anake-an/asthma-monitoring-system/hardware/README.md

# RespiroSync Hardware Integration

This directory contains the firmware source code for the physical IoT hardware used in the RespiroSync Asthma Monitoring System. The architecture utilizes a **Dual-Processor Design** to handle complex Acoustic AI alongside standard environmental telemetry.

## 1. ESP32 Master Gateway (`esp32_firmware/esp32_firmware.ino`)
The ESP32 is the central brain of the hardware system. 
*   **Connectivity:** Uses `WiFiManager` to broadcast a "RespiroSync-Setup" Hotspot if it can't find WiFi. Securely connects to Cloudflare WebSockets (WSS).
*   **Environment:** Polls the DHT22 (Climate), Sharp GP2Y1010AU0F (Dust/PM2.5), and MQ-135 (Gas, estimated ppm) sensors every 3 seconds.
*   **Comms:** Listens to UART2 (Serial2) for acoustic triggers from the Raspberry Pi Pico.
*   **Broker:** connects as the `respirosync_device` account with client id = its pairing token, and only uses `respirosync/devices/<token>/...` topics.
*   **Local alarm:** applies the thresholds it receives from the dashboard (retained `config` topic) and beeps/turns the red LED on when a reading crosses one, even when offline.
*   **LCD (16×2):** every line is centred, and only changed characters are rewritten, so it never flickers.
    *   **Start-up:**
        1. "RespiroSync ♥" slides in.
        2. "Connecting WiFi" (or "WiFi setup / Join RespiroSync" when the setup hotspot opens).
        3. "WiFi connected" with the network name.
        4. "Setting clock".
        5. "Connecting cloud".
        6. "Ready ♥ / Monitoring room".
    *   **Pages, every 5 s:** the title stays on the top line, the values sit side by side on the bottom line.
        1. **Air quality:** PM2.5 (µg/m³, shown as `ug`) and gas (ppm), e.g. `12.4ug  420ppm`. For the first **3 minutes** after power-on the gas sensor warms up: it is not read, the LCD shows a countdown (`Gas 2:15`), and gas is sent to the server as empty.
        2. **Room climate:** temperature and humidity, e.g. `28.5C  64%`, or "Check sensor" when the DHT22 fails.
        3. **Clock:** time with the online/offline icon, and the date (Malaysia time).
        4. **Daily dose? (only while due):** shown while the child's daily dose is overdue. The server sends `dose_due` in the config: a daily inhaler is used, but none was logged for 26 h.
    *   **Over a limit:** the backlight blinks 3 times and the screen stays on e.g. `!! DUST HIGH !!` / `38 > limit 35` until the reading is back under the limit. Several readings over their limits take turns every 2 s.
    *   **Other screens:**
        *   **Cough:** "Cough heard" with a moving pulse, for 2 s.
        *   **Alert from the app:** "!! ALERT !!".
        *   **Connection drops:** "Offline / Alarms still on".
    *   **Clock source:** the internet time servers (NTP). Where a network blocks those (UDP port 123), the device asks the server over MQTT (a `time_request` event, answered with a `set_time` command), every 30 s until it has the time.
    *   **Night mode (21:00-07:00, can be switched off per room in Smart Alerts):** the backlight is off unless there is an alarm or a cough. It also lights up for 30 s after the board's **BOOT** button is pressed. Outside night mode, the BOOT button shows the next page.

## 2. Raspberry Pi Pico (Acoustic AI Coprocessor)
The Raspberry Pi Pico (the **Edge AI** module) listens for coughs, so the ESP32 never handles audio.
*   **Cough model:** `pico_cough_ai/pico_cough_ai.ino` runs an Edge Impulse neural network (Audio MFE + 1D CNN, int8) from `libraries/RespiroSync_Cough_inferencing`. Core 1 records the INMP441 without a break; core 0 classifies the last second every 0.5 s (about 260 ms of work) and reports `COUGH:<level>,<score>` when the cough score, averaged over two windows in a row, reaches 0.6. Level 1-4 is the loudness, the score is how sure the model is.
*   **Training data, settings and results:** [`docs/EDGE_IMPULSE.md`](../docs/EDGE_IMPULSE.md) (93 % on validation, 86 % on unseen test sounds).
*   **Core:** use the **arduino-pico** core by Earle Philhower ("Raspberry Pi Pico/RP2040" in Boards Manager). The sketches use its `I2S i2s(INPUT)` API.
*   **Library (USB flashing only):** copy `libraries/RespiroSync_Cough_inferencing` into `Documents/Arduino/libraries`. GitHub Actions uses it straight from the repo.
*   **Checking it:** set `DEBUG_SCORES 1` and open the Serial Monitor (115200) to see every cough score.

---

## Training the model on this microphone

The model was trained on public recordings (see `docs/EDGE_IMPULSE.md`). Recordings made with the device's own INMP441 make it fit the real rooms:

1. **Flash the data collector:** `pico_cough_ai/data_collection/data_collection.ino` streams 16 kHz audio over USB, converted exactly like the Edge AI firmware does it.
2. **Stream to Edge Impulse:** install the CLI (`npm install -g edge-impulse-cli`) and run `edge-impulse-data-forwarder --frequency 16000`; it links the Pico to the "RespiroSync Cough" project.
3. **Record:** coughs labelled `cough`, and 5-10 minutes of the home labelled `noise` (talking in Malay and English, TV, fan, children playing, quiet).
4. **Retrain and test** in the Studio, then export the **Arduino library** and ship it as an Edge AI update (steps in `docs/EDGE_IMPULSE.md`).

---

## Setup Instructions

1.  Open `WIRING_GUIDE.md` and wire all hardware exactly as specified.
2.  Copy `esp32_firmware/secrets.example.h` to `esp32_firmware/secrets.h` and fill in the broker URL and the device password.
    Delete `esp32_firmware.example.ino` if it is still in the folder: the IDE compiles every `.ino` in a sketch folder together.
3.  Open `esp32_firmware/esp32_firmware.ino` in the Arduino IDE. It needs these libraries: WiFiManager, ArduinoJson 6 or 7, DHT sensor library, LiquidCrystal_I2C.
4.  Under **Tools**, choose:
    *   **Board:** "ESP32 Dev Module".
    *   **Partition Scheme:** "**Minimal SPIFFS (1.9MB APP with OTA/190KB SPIFFS)**". It has the two app slots that cloud updates need; the default scheme is too small.
5.  Connect your ESP32 via USB and click **Upload**.
6.  Once it has started, use your phone to connect to the **RespiroSync-Setup** Wi-Fi network, then enter your Wi-Fi password and the token from the dashboard.
7.  Open `pico_cough_ai/pico_cough_ai.ino` in the Arduino IDE with the arduino-pico core selected.
8.  Connect your Raspberry Pi Pico via USB and click **Upload**. The first time, hold **BOOTSEL** while plugging it in (it appears as the RPI-RP2 drive).
9.  Mount the hardware in the bedroom and monitor the dashboard!

## Updating the ESP32 from the cloud (OTA)

Once a device runs firmware 3.0.0 or newer (flashed once over USB with the partition scheme above), new versions are installed over the internet. Nothing needs to be on the same Wi-Fi. Versions read like `3.1.0 Build 261011`; see `FIRMWARE_HISTORY.md`.

**Automatic (recommended):**
1.  Raise `FIRMWARE_VERSION` (e.g. `"3.1.1"`), write what owners should read in `WHATS_NEW.txt` (one plain point per line), and push to `main`.
2.  GitHub Actions builds the firmware with the real broker settings and uploads it to the server (job "Publish ESP32 firmware to the server").
3.  Owners see the update in the dashboard.

The `.bin` contains the device password, so it is never stored in GitHub (no artifact, no release).

One-time setup:
*   **NAS:** in `backend/.env`, add `FIRMWARE_UPLOAD_TOKEN=` followed by a long random value (`openssl rand -hex 32`), then `docker compose up -d --force-recreate backend`.
*   **GitHub:** repository → Settings → Secrets and variables → Actions → New repository secret. Add these five:

| Secret | Value |
|---|---|
| `MQTT_URI` | the same as in your `secrets.h` |
| `MQTT_USERNAME` | the same as in your `secrets.h` |
| `MQTT_PASSWORD` | the same as in your `secrets.h` (no `"` or `\` in it) |
| `FIRMWARE_UPLOAD_URL` | `https://app.respirosync.online/api/firmware/upload` |
| `FIRMWARE_UPLOAD_TOKEN` | the same value as on the NAS |

If Cloudflare's "Bot Fight Mode" is on, it may block the upload; turn it off, or skip the challenge for `/api/firmware/upload`.

**By hand (without GitHub):**

**1. Build** (developer, on the PC):
1.  In `esp32_firmware.ino`, raise `FIRMWARE_VERSION` (e.g. `"3.1.1"`).
2.  In the Arduino IDE, keep the same board and partition scheme. Then **Sketch → Export Compiled Binary**.
3.  The file you need is `build/.../esp32_firmware.ino.bin`, not `.merged.bin` or `.bootloader.bin`.

**2. Publish** (developer, on the NAS):
1.  Copy the `.ino.bin` into `backend/storage/app/firmware/` in the project folder (e.g. with the NAS file manager).
2.  Run:
    ```bash
    sudo docker compose exec backend php artisan firmware:publish storage/app/firmware/esp32_firmware.ino.bin --notes="What changed"
    ```
    It checks the file is an ESP32 app image that fits, reads the version from it, and keeps it as `esp32-<version>.bin`.
3.  `--list` shows the published versions, and `--remove=3.1.1` withdraws one.

**3. Install** (owner, in the dashboard):
1.  Owners see a banner ("An update is available for Ali Bedroom") and a dot on **Account Settings**. Under **Rooms**, the device shows "Firmware 3.1.0 · ● Update available" and an **Update** button. The dialog lists "What's new" and has **Later** / **Update now**.
2.  The device must be online, and no alarm may be active.
3.  The LCD shows **Updating 45%** / **Don't unplug**, then "Update done", and restarts. Rooms then shows **✓ Up to date**.

**Safety:**
*   **The link:** the device downloads over HTTPS through a one-time link (valid 10 minutes, only for that device).
*   **The checksum:** after writing the image, the device compares its SHA-256 with the published one. On a mismatch it keeps the old firmware.
*   **Rollback:** the new firmware must reach the cloud within 2 minutes, or the ESP32 starts the previous firmware again. Rooms then shows "Update failed" with the reason. A failed download also leaves the old firmware running.
*   **Not done here:** the image is not cryptographically signed. Commercial devices also use secure boot / signed images. That burns keys into the chip permanently, so it is left out of this prototype.

## Updating the Edge AI module (Pico) from the cloud

The Pico has no internet of its own: the ESP32 downloads its update from the server, checks it (SHA-256), and sends it over the UART link. The Pico stores it in its file-system area and installs it on restart. It needs **ESP32 firmware 3.3.0+** and **Edge AI 2.0.0+**.

**One-time setup** (in this order):
1.  Update the ESP32 to **3.3.0** from the dashboard. It now talks to the Pico at 115200 baud, so coughs pause until step 2.
2.  Flash the Pico once over USB:
    *   pull the VSYS wire off first, if the Pico is powered from the ESP32;
    *   select Board "Raspberry Pi Pico" and **Tools → Flash Size → "2MB (Sketch: 1MB, FS: 1MB)"**;
    *   upload `pico_cough_ai/pico_cough_ai.ino`, then put the VSYS wire back.
3.  Within 30 seconds, Rooms in the dashboard shows **Edge AI 2.0.0**.

**After that:** raise `EDGE_AI_VERSION`, write `pico_cough_ai/WHATS_NEW.txt`, and push to `main`. GitHub Actions builds the Edge AI firmware and uploads it. Owners see **Edge AI · ● Update available** under Rooms and press **Update**; the LCD shows `Updating 45%` / `Edge AI`. A new Edge Impulse model ships the same way, inside the Pico firmware.

By hand: export the Pico build (Sketch → Export Compiled Binary, with the same Flash Size), copy `pico_cough_ai.ino.bin` (not the `.uf2`) into `backend/storage/app/firmware/`, and run `php artisan firmware:publish storage/app/firmware/pico_cough_ai.ino.bin`.
