anake-an/asthma-monitoring-system/docs/PROJECT_EXPLANATION.md

# 🫁 RespiroSync: System Architecture & Code Explanation

How the hardware, AI, backend and frontend fit together, what each part really does, and where the code lives.

---

## 1. Hardware (dual-processor)

### 🎤 Raspberry Pi Pico: Edge AI cough detector
*   **Hardware:** Raspberry Pi Pico + INMP441 I2S microphone.
*   **Why a second chip:** continuous 16 kHz audio sampling is kept off the ESP32, which handles Wi-Fi, TLS and sensors.
*   **How it works:** an Edge Impulse neural network (Audio MFE features + a small 1D CNN, int8) classifies each second of sound as **cough** or **noise**. Core 1 records without a break; core 0 classifies the last second every 0.25 s (about 140 ms on the RP2040). A cough is reported when 2 of the last 3 windows reach the room's threshold (0.6 to start, tuned by the cough reviews), at most once per 1.5 s; a window with a clear burst is first scaled into the loudness band the model learned (level guard). A watchdog restarts the Pico if it hangs.
*   **Accuracy:** 93 % on validation and 86 % on test sounds it never heard (84 % of coughs caught, 87 % of other sounds ignored, the rest marked uncertain and not reported). Training data and settings: `docs/EDGE_IMPULSE.md`.
*   **Limits (be honest in the report):** trained on public recordings (phones, a lab microphone), not yet on the INMP441 in a real home, so it can miss coughs or take another sound for one. Recording the home through the device and retraining (`hardware/README.md`) is the next step. It recognises a cough sound; it does not diagnose anything.
*   **Code:** `hardware/pico_cough_ai/pico_cough_ai.ino`, model in `hardware/libraries/RespiroSync_Cough_inferencing`
*   **Output:** `COUGH:<level 1-4 (loudness)>,<cough score 0.00-1.00>` over UART to the ESP32.

### 📡 ESP32: gateway and environment monitor
*   **Hardware:** ESP32 + DHT22 + MQ-135 + Sharp GP2Y1010AU0F (or the pin-compatible GP2Y1014AU0F), passive buzzer, red/green LEDs, 16x2 I2C LCD behind a BSS138 level shifter, MB-102 5 V supply for the sensors.
*   **How it works:**
    *   Reads the sensors every 3 s and publishes them to `respirosync/devices/<token>/telemetry`. Dust and gas are averaged over the last 4 readings (~12 s); the same smoothed values drive the local alarm, so the device and dashboard agree. A failed DHT22 read is sent as `null`, never as 0. Gas is an estimated CO₂-equivalent ppm (MQ-135 datasheet curve, calibrated against the cleanest air seen since power-on taken as 420 ppm), not a measured CO₂ value.
    *   Forwards each Pico detection to `respirosync/devices/<token>/events`.
    *   Receives its owner's thresholds on `respirosync/devices/<token>/config` (a retained message, so they arrive again after every reconnect) and sounds the buzzer/red LED when a reading stays over its threshold for 3 readings in a row (about 9 s on top of the 12 s average); it stops after 3 readings under the threshold minus a margin, so a value hovering at its limit does not switch it on and off. This works offline too, using the last thresholds received (kept in flash across restarts, firmware 3.5.0). The dashboard can mute the buzzer; holding the board's BOOT button for 2 s silences it for 10 minutes. Coughs heard while offline are kept (up to 40, with their time) and sent when the connection is back; the server stores them without an alert.
    *   Obeys `factory_reset`, `buzzer_on`, `buzzer_off` and `set_time` on `respirosync/devices/<token>/commands`.
    *   **LCD:** every line is centred.
        *   Start-up steps, then pages every 5 s: Air quality, Room climate, the clock, and "Daily dose?" while one is due.
        *   Alerts and coughs interrupt the pages; night mode switches the backlight off from 21:00 to 07:00.
        *   The gas sensor is not read for its first 3 minutes (warm-up).
        *   The clock comes from NTP, or from the server over MQTT where NTP is blocked.
        *   Cloud firmware updates: owners press Update in the dashboard; the device downloads the new build from the server over HTTPS, checks its SHA-256, installs it and rolls back if it does not reach the cloud.
*   **Code:** `hardware/esp32_firmware/esp32_firmware.ino` (credentials in a gitignored `secrets.h`).

---

## 2. AI

### A. On-device detection
The Edge Impulse cough model on the Pico, above. It produces cough events with a score; it does not diagnose anything.

### B. Cloud risk model (`ai_engine/main.py`, FastAPI + scikit-learn)
*   **Two levels (DESIGN §5):** a **room model per device** (`/train/room?device_id=`, `device_<id>_baseline.pkl`: what is normal for that room, needs only telemetry) and a **risk model per child** (`/train/risk?patient_id=`, `patient_<id>_model.pkl`: what preceded that child's rescue doses and cough clusters, from the windows of all of their rooms in time order; shared rooms never train a child's model). `/predict?device_id=` answers for one room: its baseline (Stage 1) or its child's risk model fed with that room's latest window (Stage 2), with limits from the room's own learned normal. The backend checks access before every call (`AiController`, `ai:optimize`); `php artisan ai:train` (every 4 h) trains every room, then every child.
*   **Data:** 10-minute windows of average PM2.5, temperature and humidity, cough count, and whether a controller (daily) dose was logged in the last 24 h. Gaps up to 30 minutes are interpolated; longer gaps (device offline) are dropped rather than invented. Cough events the caregiver marked as **false alarm** are excluded.
*   **Label:** "a rescue inhaler dose or 2+ coughs within the next 60 minutes". Controller (daily, preventive) doses are not episodes; they are the input above.
*   **Stage 1 (no events yet):** z-score of the current readings against the room's own baseline → one of three fixed levels (shown as Normal / Unusual / Very unusual). An anomaly level, not a probability.
*   **Stage 2 (enough episodes):** below 12 episode windows (about 2 episodes) the account stays on Stage 1. Then logistic regression (stable on little data), and a Random Forest from 20 episode windows (about 4 episodes); both with balanced class weights. Evaluation on the most recent 25% of windows, which the model did not train on, reports **recall** (share of later episodes it flagged) and **precision** (share of its warnings that were real), never plain accuracy (about 95% of windows are "safe", so always saying "safe" would score about 95%). With fewer than 2 later episode windows, no score is claimed.
*   **Threshold suggestions:** `/predict` returns suggested thresholds learned from the room: mean + 3 std of each room reading (gas keeps 1000 ppm: the MQ-135 estimate drifts too much to learn), tightened toward mean + 2 std as Stage 1 sees the room as unusual / very unusual, or by the Stage 2 risk model; never below the room's own normal range (mean + 2 std) and always within a safety range. The scheduler runs `php artisan ai:optimize` every 5 minutes for every account with "AI optimization" enabled. Each limit the user sets in Smart Alerts is a **cap**: the AI may lower the effective limit below it (toward the learned limit, further when the room is unusual), never raise it above, and never changes a **locked** limit. It changes nothing until the room baseline covers 24 h of readings, and then changes each limit at most once per 24 h, by at most 10 % (a user change starts a fresh day for that limit; lowering the cap always applies at once). While the AI is learning or has less than 24 h of readings, every limit is the user's own value. Every change is logged with its reason and shown in the Activity Log, one line per update. Devices are only re-published when a limit changes. The dashboard marks limits the AI lowered ("AI"), locked limits ("locked"), and limits inside the room's usual range ("!", expect frequent alerts).
*   **Missed daily dose rule (a rule, not AI):** if the account logged a daily (controller) dose in the last 7 days but none in the last 26 h, `ai:optimize` lowers every unlocked limit by 15 % until a dose is logged (`hardware_configs.missed_dose_base` keeps the limits without the rule, so it never compounds). Accounts that never log daily doses are never affected. Changes are logged as "Rule"; the dashboard marks the limits "dose". Turning AI optimization off restores every limit to the user's own value and ends the rule.

---

## 3. Backend & cloud infrastructure

### 📨 Mosquitto (MQTT broker): `mosquitto/config/`
*   `allow_anonymous false`, with two accounts: `respirosync_backend` (full access to `respirosync/#`) and `respirosync_device` (shared by devices).
*   `acl` pins every device to `respirosync/devices/<its client id>/...`. A device cannot read another device's data, learn other tokens, or publish as another device. The password file is created on the server and never committed.

### ⚙️ Laravel 12
*   **MQTT worker:** `app/Console/Commands/MqttSubscribe.php` subscribes to `respirosync/devices/+/telemetry` and `/events` and hands each message to `app/Services/DeviceMessageHandler.php`. Device identity comes from the topic, never from the payload.
*   **Alert rule:** a cough raises an alert when there are **3 coughs in 10 minutes**, or **2 coughs in 10 minutes where this one has a cough score ≥ 0.8**. A single cough never alerts on its own. At most **one email per device per 10 minutes**. A mail failure is logged and never stops the worker.
*   **Other alerts (email + push, same recipients):**
    *   **A reading over its room's limit for 5 minutes**, at most once an hour per reading (`DeviceMessageHandler::checkLimits`).
    *   **A device silent for 30 minutes**, once per outage, with a "back online" push afterwards (`devices:offline-alerts`).
    *   **On the LCD only:** "Daily dose?" while a child's daily dose is overdue (`devices:dose-reminders`).
*   **Alert email:** `resources/views/emails/cough_alert.blade.php` shows the cough count and the device-reported cough score, or "Not reported by device". It never shows an invented confidence.
*   **Patients, rooms and access:** a **patient** (the child: display name, optional birth year) is separate from the login; `patient_user` gives each account a role (owner now; caregiver and viewer with sharing). A **device** is a room: it belongs to one child or is a **shared room** (coughs shown, never counted for a child). Alert limits (`hardware_configs`) are **per device**; inhaler doses (`inhaler_logs.patient_id`) are per child; telemetry and coughs come from the device. Every API call resolves its `device_id` / `patient_id` through one check (`AppPoliciesDevicePolicy`, `PatientPolicy`, `Controller::device()` / `::patient()`): anything not yours is a 404. Devices record `last_seen_at` on every message; online = a message in the last 20 s.
*   **REST API:** `routes/api.php`, protected by Sanctum tokens.
*   **Tests:** `backend/tests/` (`php artisan test` on a development machine or an isolated container; never inside the production backend container, see README).

---

## 4. Frontend (`frontend/`)
*   **Live Monitor:** latest readings; shows "Sensor Error" when the DHT22 failed.
*   **Command Center:** thresholds and buzzer mute. Saving pushes the new config to every device on the account.
*   **AI Risk panel:** model stage, risk level, and coughs in the last hour.
*   **Cough History:** each event's cough score and whether it was an Alert or only Logged; caregivers can mark events as false alarms, which then feeds into training.

---

## 5. Deployment & security
*   **Docker Compose:** frontend, backend, MQTT worker, scheduler, AI engine, MySQL, Mosquitto, cloudflared. Secrets come from `.env` (see `.env.example`).
*   **Cloudflare Tunnel:** the NAS opens an outbound tunnel. The dashboard and the broker's WebSocket listener are reachable through Cloudflare without port forwarding, and every service binds only to `127.0.0.1` on the host.
*   **Broker hardening:** authentication + per-device ACL (above). TLS terminates at Cloudflare, and the ESP32 verifies Cloudflare's certificate.
