anake-an/asthma-monitoring-system/hardware/WIRING_GUIDE.md

# RespiroSync Hardware Wiring Guide

Wiring for the dual-processor build: an **ESP32** (sensors, display, alarm, Wi-Fi/MQTT) and a **Raspberry Pi Pico**, the **Edge AI** module (microphone, cough detection), linked over UART.

> [!WARNING]
> **Hardware liability disclaimer.** This is a reference build. Modules vary by manufacturer: check pin labels against your own parts and their datasheets before powering on. The authors are not responsible for damaged components. Proceed at your own risk.

---

## 0. Parts list (reference build)

| Part | Notes |
|---|---|
| Raspberry Pi Pico (Edge AI module) | arduino-pico core, Flash Size "2MB (Sketch: 1MB, FS: 1MB)" |
| ESP32 dev board (ESP32-WROOM) | arduino-esp32 core 2.0.x or 3.x, Partition Scheme "Minimal SPIFFS (1.9MB APP with OTA)" |
| USB cable (data, not charge-only) + 5 V 1-2 A USB charger | powers the ESP32 (and the Pico through it) |
| INMP441 I2S microphone | 3.3 V only |
| DHT22, 3-pin module (or bare 4-pin sensor) | the module has its pull-up, a bare sensor needs 10 kΩ |
| MQ-135 gas sensor module | 5 V heater |
| Sharp GP2Y1010AU0F dust sensor, bare, 6-wire cable | + 150 Ω (220 Ω ∥ 470 Ω) and 220 µF |
| 16×2 LCD with PCF8574T I2C backpack | 5 V |
| BSS138 4-channel logic level shifter | for the LCD's I2C lines |
| Passive buzzer (2 terminals, `+` / `−`) | + 220 Ω series resistor |
| Red and green LED | + 220 Ω each |
| MB-102 breadboard power module + 9 V DC adapter (barrel plug, 1 A) | 5 V rail for the sensors and LCD |
| Resistors: 10 kΩ ×2-3, 20 kΩ ×2, 220 Ω ×4, 470 Ω ×1 | third 10 kΩ only for a bare DHT22 |
| Capacitors: 1000 µF ×1, 220 µF ×1 (electrolytic) | long leg = `+`, striped side = `−` |

---

## 1. Power (read first)

Two supplies: a **DC adapter** for the breadboard (sensors and LCD) and **USB** for the ESP32, which also powers the Pico.
```
9 V DC adapter ──► MB-102 barrel jack (rail jumper on 5 V)
                      └──► 5 V rail: MQ-135, Sharp sensor, LCD, level shifter HV

USB (5 V 1-2 A charger, or the PC) ──► ESP32
                      ├──► its 3V3 pin ──► DHT22, level shifter LV
                      └──► its 5V/VIN pin ──► Pico VSYS (pin 39) ──► Pico 3V3 (OUT) ──► INMP441

GND: MB-102 GND, ESP32 GND and Pico GND all tied together
```
(The Pico can also run from its own USB instead of the VSYS wire: section 2.)

Rules:
1. **One common ground.** Every GND (MB-102, ESP32, Pico, every sensor) must be connected, or the UART link and the analog readings fail.
2. **Never connect the MB-102's 5 V to the ESP32's 5 V/VIN pin or to the Pico's VSYS/VBUS.** The boards run from USB; two 5 V sources fighting each other can damage either. Only the grounds are shared. (The ESP32's own 5V/VIN pin may feed the Pico's VSYS: section 2.)
3. **MB-102 jumper:** the rail that feeds the sensors must be set to **5 V**, not 3.3 V. Leave the other rail off or unused. Feed the MB-102 from its **DC barrel jack** (6.5-12 V, 9 V recommended) **or** its own USB socket, never both at once.
4. **Why split:** the MB-102 uses linear regulators. At 9 V in, every 100 mA it supplies turns into ~0.4 W of heat. The sensors and LCD (~200 mA) are fine. Adding the ESP32's Wi-Fi peaks and the Pico would overheat it.
5. **Bulk capacitor:** 1000 µF across the MB-102's 5 V rail and GND, close to the module (`+` to 5 V).
6. **Power-on order: DC adapter (MB-102) first, then the ESP32's USB** (or press the ESP32's EN/RST button after switching the MB-102 on). If the ESP32 boots while the LCD is unpowered, the LCD misses its initialisation and shows garbage characters until the ESP32 is reset. The Pico starts with the ESP32.
7. **Never feed 5 V into an ESP32 or Pico pin.** The two 5 V analog sensors go through 10 kΩ / 20 kΩ dividers (5 V → 3.33 V), and the LCD's I2C lines go through the level shifter.

*(An LM2596 adjustable buck converter can replace the MB-102 only after its output has been set to 5.0 V with a multimeter, with nothing connected. Unadjusted, it can output close to its input voltage, which destroys the Pico and the 5 V sensors.)*

---

## 2. Raspberry Pi Pico (Edge AI module: cough detection)

Flash it once over USB with **Tools → Flash Size → "2MB (Sketch: 1MB, FS: 1MB)"**. The file-system half receives its cloud updates. After that, updates come from the dashboard through the ESP32.

### INMP441 microphone (3.3 V only)
| INMP441 | Pico |
|---|---|
| VDD | **3V3 (OUT)** (pin 36) |
| GND | GND |
| L/R | GND (left channel) |
| SCK | **GP14** |
| WS | **GP15** |
| SD | **GP13** |

> The arduino-pico I2S driver requires WS (LRCLK) on the pin right after SCK (BCLK). Older versions of this guide had WS on GP13 and SD on GP15, which cannot work.

### Pico ↔ ESP32 (UART, both 3.3 V: direct connection)
| Pico | ESP32 |
|---|---|
| GP0 (UART0 TX) | **GPIO 16** (UART2 RX) |
| GP1 (UART0 RX) | **GPIO 17** (UART2 TX) |
| GND | GND |

TX goes to RX, and RX goes to TX. Swapping them is the most common reason no cough arrives.

The link runs at **115200 baud** (ESP32 firmware 3.3.0+ and Edge AI 2.0.0+). Both sides must be on those versions: older builds used 9600 and cannot talk to the new ones.

### Layout: Pico pins and the connections to the ESP32
The Pico's pin numbers count down its left side from the USB end (pin 1 = GP0), then up its right side (pin 21 = GP16 at the bottom, pin 40 = VBUS at the top).
```
                 USB (only to flash it: pull the VSYS wire off first)
              ┌────┴────┐
   GP0  pin 1 │●       ●│ pin 40 VBUS
   GP1  pin 2 │●       ●│ pin 39 VSYS  ◄── ESP32 5V/VIN (its power)
   GND  pin 3 │●       ●│ pin 38 GND
              │   ...   │ pin 36 3V3 (OUT) ──► INMP441 VDD
              │         │
   GP13 pin 17│●        │  ◄── INMP441 SD
   GP14 pin 19│●        │  ──► INMP441 SCK
   GP15 pin 20│●        │  ──► INMP441 WS
              └─────────┘

   Pico pin 1 (GP0) ───────────────► ESP32 GPIO 16 (RX2)
   Pico pin 2 (GP1) ◄─────────────── ESP32 GPIO 17 (TX2)
   Pico pin 3 (GND) ───────────────► ESP32 GND   (shared ground: required)
```
Power the Pico from the ESP32 as below (the reference build), or from its own USB. Never connect it to the MB-102's 5 V.

### Powering the Pico from the ESP32 (one USB cable for both, the reference build)
| ESP32 | Pico |
|---|---|
| **5V** (some boards: **VIN**) | **VSYS** (pin 39: right-hand side, second pin from the USB end) |
| GND | GND (already connected for the UART) |

The Pico needs about 25 mA (about 27 mA with the microphone), which the ESP32's USB supply easily gives. Rules:
- **VSYS only.** Not VBUS (pin 40), and never the Pico's **3V3** (pin 36): that pin is an output.
- **Never both supplies at once.** Pull the VSYS wire off before plugging the Pico's own USB into the PC (to flash it or open its Serial Monitor), so two 5 V supplies never meet. Optional: a 1N5817/1N5819 Schottky diode in the VSYS wire (stripe towards the Pico) makes it safe to keep both connected.
- **A good supply for the ESP32:** a PC port, or a 5 V 1-2 A charger. A weak one makes the ESP32 restart when Wi-Fi peaks.

When the INMP441 arrives, add it as in the table above (GP13, GP14, GP15, 3V3 (OUT) on pin 36, GND). No change to the firmware is needed.

---

## 3. ESP32 (sensors, display, alarm)

### DHT22
**3-pin module (sensor on a small board).** Pin order differs between makers, so follow the labels printed on the board. These modules usually include the 10 kΩ pull-up (a small resistor marked `103`). If yours has none, add one from DATA to 3V3.

| Module label | Connect to |
|---|---|
| `+` / `VCC` | ESP32 **3V3** |
| `out` / `DAT` / `S` | ESP32 **GPIO 4** |
| `−` / `GND` | GND |

**Bare 4-pin sensor** (pins numbered left to right, grille facing you):

| DHT22 pin | Connect to |
|---|---|
| 1 VCC | ESP32 **3V3** |
| 2 DATA | ESP32 **GPIO 4**, plus a **10 kΩ** from DATA to 3V3 (pull-up) |
| 3 NC | not connected |
| 4 GND | GND |

### MQ-135 module (5 V heater)
| MQ-135 | Connect to |
|---|---|
| VCC | MB-102 **5 V** rail |
| GND | GND |
| AO | **10 kΩ** ➔ ESP32 **GPIO 34**, and **20 kΩ** from GPIO 34 to GND |
| DO | not used |

A new MQ-135 needs about **24-48 hours** of heating before its readings settle.

**Estimated ppm:** the firmware converts the reading to the sensor's resistance and applies the MQ-135 datasheet curve, calibrating against the cleanest air seen since power-on (taken as fresh air, 420 ppm CO₂). For the best estimate, power the device up in a well-ventilated room. The value is a CO₂-equivalent estimate: the sensor also reacts to other gases and drifts with temperature and humidity. The module's load resistor cancels out of the calculation, so its value does not matter.

### Sharp GP2Y1010AU0F dust sensor (bare, 6-wire cable)
Pin 1 is marked on the sensor's connector. Cable colours vary between suppliers, so count from the connector, not the colours.

| Sharp pin | Connect to |
|---|---|
| 1 V-LED | **~150 Ω** to the MB-102 **5 V** rail (a **220 Ω and a 470 Ω in parallel** = 149.9 Ω), and a **220 µF** capacitor from pin 1 to GND (`+` on pin 1) |
| 2 LED-GND | GND |
| 3 LED | ESP32 **GPIO 5** (the firmware pulses it, LOW = LED on) |
| 4 S-GND | GND |
| 5 Vo | **10 kΩ** ➔ ESP32 **GPIO 35**, and **20 kΩ** from GPIO 35 to GND |
| 6 Vcc | MB-102 **5 V** rail |

The 150 Ω and 220 µF are required by the datasheet: the capacitor supplies the LED's short current pulse. The firmware multiplies the reading by 1.5 to undo the divider (`DUST_DIVIDER_RATIO`). The GP2Y1014AU0F has the same pinout and wiring.

**Wire colours are not standardised** between cable suppliers. Identify pins by position (pin 6, Vcc, is the red wire at one end of the connector). **Calibration:** each sensor has its own clean-air output (0-1.5 V). The firmware learns it as the lowest reading since power-on and converts the rise above it with the datasheet's typical sensitivity (0.5 V per 100 µg/m³). Power the device up in clean air. The Serial Monitor shows the learned baseline. The value is an estimated dust density, not a size-selective PM2.5 measurement.

### LCD 16×2 (PCF8574T backpack) through the BSS138 level shifter
The backpack runs on 5 V and pulls SDA/SCL up to 5 V, so the I2C lines go through the level shifter.

| From | To |
|---|---|
| LCD VCC | MB-102 **5 V** rail |
| LCD GND | GND |
| Level shifter **HV** | MB-102 **5 V** rail |
| Level shifter **LV** | ESP32 **3V3** |
| Level shifter GND (both sides) | GND |
| LCD **SDA** | level shifter **HV1** |
| LCD **SCL** | level shifter **HV2** |
| level shifter **LV1** | ESP32 **GPIO 21** (SDA) |
| level shifter **LV2** | ESP32 **GPIO 22** (SCL) |

The firmware uses I2C address `0x27`. If the screen lights up but stays blank, try `0x3F` in `esp32_firmware.ino`, then adjust the contrast trimmer on the backpack.

### Passive buzzer
| Buzzer | Connect to |
|---|---|
| `+` | **220 Ω** ➔ ESP32 **GPIO 18** |
| `−` | GND |

The firmware drives it with a 2.7 kHz `tone()`. The 220 Ω keeps the pin current around 14 mA even if the buzzer is a low-resistance magnetic type. Never connect it to the pin without the resistor. If the buzzer board has more than two pins, pins with the same mark are connected together.

### Status LEDs
| From | Through | To |
|---|---|---|
| ESP32 **GPIO 19** | 220 Ω | **green** LED anode (long leg) |
| ESP32 **GPIO 23** | 220 Ω | **red** LED anode (long leg) |
| both LED cathodes (short leg) | | GND |

Green = connected and normal. Red = alarm, or not connected to the broker.

---

## 4. Pin summary

| ESP32 pin | Used for | | Pico pin | Used for |
|---|---|---|---|---|
| GPIO 4 | DHT22 DATA | | GP0 | UART TX → ESP32 GPIO 16 |
| GPIO 5 | Sharp LED pulse | | GP1 | UART RX ← ESP32 GPIO 17 |
| GPIO 0 | BOOT button: wake the LCD, next page | | | |
| GPIO 16 | UART RX ← Pico GP0 | | GP13 | INMP441 SD |
| GPIO 17 | UART TX → Pico GP1 | | GP14 | INMP441 SCK |
| GPIO 18 | Buzzer (via 220 Ω) | | GP15 | INMP441 WS |
| GPIO 19 | Green LED | | 3V3 (OUT), pin 36 | INMP441 VDD |
| GPIO 21 / 22 | LCD SDA / SCL (via level shifter) | | VSYS, pin 39 | power ← ESP32 5V/VIN |
| 5V / VIN | Pico VSYS (power out) | | GND, pin 3 | shared ground with the ESP32 |
| GPIO 23 | Red LED | | | |
| GPIO 34 | MQ-135 (via divider) | | | |
| GPIO 35 | Sharp Vo (via divider) | | | |

---

## 5. Bring-up order

Test each part on its own before adding the next. It makes faults easy to find.

1. **Pico + INMP441** on the Pico's own USB. Flash `pico_cough_ai.ino` with **Flash Size "2MB (Sketch: 1MB, FS: 1MB)"** (and `DEBUG_LEVELS 1` to calibrate): open the Serial Plotter, clap or cough, and set `RMS_THRESHOLD` above your room's background level. Then set `DEBUG_LEVELS` back to 0 and flash again.
2. **ESP32 alone** on USB. Fill `secrets.h`, choose **Partition Scheme "Minimal SPIFFS (1.9MB APP with OTA)"**, flash with *Erase All Flash Before Sketch Upload* enabled (the first time only: it also erases the token and Wi-Fi), pair it from the dashboard, and check that it appears online.
3. Plug in the **DC adapter** (MB-102 on 5 V) and add the **DHT22**, **LEDs**, **buzzer** and **LCD** (with the level shifter). Reset the ESP32 after the MB-102 is on. Temperature and humidity should appear on the LCD and the dashboard.
4. Add the **MQ-135** and the **Sharp sensor**. Readings should appear within a few seconds. Gas shows a 3-minute warm-up countdown, and the MQ-135 drifts during its first day.
5. Unplug the Pico's USB, then connect the **Pico ↔ ESP32 UART** (pins 1, 2, 3) and the **VSYS power wire** (ESP32 5V → Pico pin 39). In the dashboard, Rooms shows "Edge AI 2.0.x". Cough (or clap) near the microphone: the Pico's LED blinks, the LCD shows "Cough heard" and chirps, and the cough appears in the dashboard's cough history.

After this, both chips are updated from the dashboard (Account Settings → Rooms): no more USB flashing.
