anake-an/asthma-monitoring-system/hardware/FIRMWARE_HISTORY.md

# RespiroSync Room Monitor: firmware history

Two parts have their own versions: the **device firmware** (ESP32) and the **Edge AI** module (Raspberry Pi Pico, cough detection). Both are updated from the dashboard.

Product **RespiroSync Room Monitor**, model **RS-100**, hardware **rev A** (ESP32 gateway + Raspberry Pi Pico cough sensor).

Firmware versions read like **`3.1.0 Build 261011`**, in the style of other connected devices:
- **3.1.0** is set in `esp32_firmware.ino` (`FIRMWARE_VERSION`):
  - **major** (3.x.x) changes need something new from the owner (a USB re-flash, new setup);
  - **feature** (x.1.x) adds things the device does;
  - **fix** (x.x.1) only corrects.
- **Build 261011** is added by CI when it builds the firmware: the build date (YYMMDD, Malaysia time), plus `.2`, `.3`… for a second or third firmware build that day. A build made in the Arduino IDE says `dev`.
- The website has its own versions (6.x, `CHANGELOG.md`). The two are independent.

Raise `FIRMWARE_VERSION` and write `WHATS_NEW.txt` (what owners read in the update dialog) for every firmware you publish.

| Firmware | Build | What changed |
|---|---|---|
| **3.4.0** | 261013.3 | Passes the room's cough threshold (`cough_threshold` in the config) to the Edge AI module (`THR:`), again after each hello; forwards possible coughs (`MAYBE:`) as `"possible": true`, without the cough screen or chirp |
| 3.3.2 | 261013.2 | Asks 1.1.1.1 first, then the router, then 8.8.8.8 (the router answered some lookups with an error, which lwIP does not retry elsewhere); re-applied after every disconnect. Fixes the broker connection needing several tries |
| 3.3.1 | 261013 | Backup DNS server (1.1.1.1) and up to 3 lookups before an update download, so a router that misses one DNS answer no longer fails the update; "Server not found" when it cannot look the server up; finds the LCD at 0x27 or 0x3F by itself |
| **3.3.0** | 261010.9 | Passes Edge AI updates on to the Pico; faster link to it (115200). **Needs Edge AI 2.0.0** (older Pico builds talk at 9600) |
| 3.2.0 | 261010.8 | Night mode can be switched off per room in Smart Alerts |
| 3.1.0 | 261010.7 | Start-up shows the firmware version and build; clearer update screens ("Updating 45%", "Don't unplug"); reports its build stamp |
| 3.0.1 | 261010.6 | Start-up screens slower, so they can be read *(first update installed from the cloud; it called itself "6.2.1")* |
| **3.0.0** | 261010.5 | Cloud updates from the dashboard, with checksum and rollback; new memory layout (two app slots), **one USB re-flash needed** *(called itself "6.2.0")* |
| 2.3.0 | 261010.4 | Updates over Wi-Fi from the Arduino IDE (removed in 3.0.0) |
| 2.2.0 | 261010.3 | Centred LCD layout with titled pages; gas sensor warm-up (3 min); clock from the server when NTP is blocked |
| 2.1.0 | 261010.2 | LCD pages and icons, alert screens, cough animation, night mode, "Daily dose?" reminder |
| 2.0.2 | 261010 | Humidity limit 75 % by default (was 60 %) |
| 2.0.1 | 261009.2 | Small fixes alongside the dashboard update |
| **2.0.0** | 261009 | Secure broker login with a per-device topic, gas in ppm, self-calibrating dust sensor, passive buzzer, readings every 3 s. **Older firmware cannot connect** |
| 1.1.0 | 261008.2 | LCD and LED feedback |
| 1.0.0 | 261008 | First firmware: sensors, MQTT, setup hotspot |

The builds before 3.1.0 were numbered afterwards from the Git history of `hardware/esp32_firmware/`. The server shows a device that still reports "6.2.0" / "6.2.1" as 3.0.0 / 3.0.1.

## Edge AI (Raspberry Pi Pico)

The module that listens for coughs. Same version style (`2.0.0 Build 261011`): `EDGE_AI_VERSION` in `pico_cough_ai/pico_cough_ai.ino`, and `pico_cough_ai/WHATS_NEW.txt` for owners. Its updates come from the server through the ESP32 (firmware 3.3.0 or newer).

| Edge AI | Build | What changed |
|---|---|---|
| **3.1.0** | 261013.3 | Model 1.0.4, retrained with 33 coughs and 6 min of room sound recorded through the device's own INMP441 (396 cough clips with shifts and quieter copies); bigger network (16 + 32 filters). Cough threshold set by the ESP32 (`THR:`); possible coughs (`MAYBE:`) up to 0.15 under it in a window with a clear burst, at most one per 20 s |
| 3.0.2 | 261013.2 | 200 Hz high-pass filter (mains hum measured at ~10x the level above 1 kHz); gain 4x instead of 8x (coughs scored 0.00 at 8x); USB command `rec <seconds>` streams raw audio as the model hears it; `hardware/tools/record_audio.ps1` saves it as WAV and `cut_clips.ps1` cuts training clips |
| 3.0.1 | 261013 | Prints the cough score and microphone level (loudest 16 ms) on USB serial whenever a PC has the port open; replaces the DEBUG_SCORES switch |
| **3.0.0** | 261011 | **Edge Impulse cough model**: a neural network tells coughs from other sounds (was a loudness check); the report carries a cough score. Model and results in `docs/EDGE_IMPULSE.md` |
| 2.0.1 | 261010.5 | Repeats its version to the ESP32 every 10 minutes |
| **2.0.0** | 261010.4 | Updates from the dashboard (through the ESP32); faster link (115200); reports its version. **One USB flash needed**, with Flash Size "2MB (Sketch: 1MB, FS: 1MB)" |
| 1.3.0 | 261010.3 | Test mode removed |
| 1.2.1 | 261010.2 | No false coughs from electrical noise (data line pulled down, 3 s settle, 32 ms minimum) |
| 1.2.0 | 261010 | Test button / serial test mode |
| 1.1.0 | 261009 | Detection strength (0-1) and the correct microphone pins |
| 1.0.0 | 261008 | First version: reports loud bursts to the ESP32 |

The builds before 2.0.0 were numbered afterwards from the Git history of `hardware/pico_cough_ai/`.
