anake-an/asthma-monitoring-system/(commit log)

2026-10-08 fix: smooth logout button UX transitions
2026-10-08 feat: add LCD and LED feedback to ESP32 firmware
2026-10-08 fix: rename and update primary esp32_firmware.ino
2026-10-08 feat: add reset password page component for user authentication flow
2026-10-09 feat: lock down broker, scope data per user, honest AI output
    Broker
    - Disable anonymous access; add password_file, acl_file and persistence.
    - New ACL: respirosync_backend (full respirosync/#) and a shared
    respirosync_device account pinned by client id to
    respirosync/devices/<token>/{telemetry,events,config,commands}.
    - Replace respirosync/telemetry and asthma/config with per-device topics.
    Backend
    - Per-user hardware_configs and inhaler_logs.user_id (migration
    2026_10_09_000000 backfills single-account installs); fix IDOR in
    report/inhaler/verify.
    - Cough alerts: 3 coughs/10 min, or 2 with strength >= 0.8; at most one
    email per device per 10 min. Remove hardcoded 98.5% claim and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
    [data_collection.ino, esp32_firmware.ino, pico_cough_ai.ino, secrets.example.h]
2026-10-09 fix: write event timestamps from the app clock, not the DB default
    recorded_at and administered_at came from the column default
    (CURRENT_TIMESTAMP), but the cough-alert window, the alert cooldown and the
    "last 4 hours" inhaler check compare them with now() in the app timezone.
    When the DB clock runs in a different zone (always UTC on SQLite; on MySQL
    whatever the server's time_zone is), recent coughs fall outside the window
    and alerts never fire. CI caught it with APP_TIMEZONE=Asia/Kuala_Lumpur.
    Set the timestamps explicitly with now() for telemetry, cough events and
    both inhaler-log paths.
2026-10-09 fix(security): no known default login, remove global data wipe command
    - DatabaseSeeder refused to stay a public credential: it created
    admin@asthma.local / password123 on any install that ran --seed. It now
    refuses in production and, locally, creates dev@respirosync.test with a
    random password printed once. Tests cover both.
    - Remove TestDataSeeder (pre-devices schema, never referenced).
    - Remove the clear:data artisan command, which deleted every account's
    devices, telemetry, coughs and doses with no confirmation.
    - Login placeholder no longer advertises the old admin email.
    - command.md no longer suggests migrate:fresh --seed.
2026-10-09 fix(security): upgrade to Laravel 12 and webpush 13
    Laravel 11 no longer receives security fixes. composer audit on the 11.x
    lock reports CVE-2026-48019 (high): CRLF injection through the default
    `email` validation rule. Registration validates with that rule and the app
    later mails the stored address (password reset, cough alerts). Fixed only
    in laravel/framework >= 12.60.
    - laravel/framework ^11.31 -> ^12.69 (stays on PHP 8.2; 13.x needs 8.3).
    - laravel-notification-channels/webpush ^8.0 -> ^13.0 (8.x does not
    support Laravel 12). Pulls minishlink/web-push 11 and web-token/jwt-library,
    replacing six abandoned web-token/phpasn1 packages.
    - New migration: push_subscriptions.endpoint 500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
2026-10-09 chore: commit backend composer.lock
    Generated with `composer update --no-install` in webdevops/php:8.2-alpine,
    the image the backend runs in, from the composer.json of 17451fa.
    laravel/framework v12.69.3, webpush 13.0.1, minishlink/web-push 11.0.0.
    `composer audit --locked`: no advisories, no abandoned packages.
    Every install (CI, the NAS, a fresh clone) now gets the same versions.
2026-10-09 chore: tidy repo layout and docs
    - docs/: move PROJECT_EXPLANATION.md there; hardware/command.md becomes
    docs/OPERATIONS.md and is rewritten for the current setup (run from the
    project folder, sudo on the NAS, backups to the home folder, history
    cleared in foreign-key order instead of TRUNCATE, migrate:fresh --force
    inside the container, safe test command).
    - README: list docs/ and .github/workflows/ in the structure, add a
    documentation index.
    - Remove frontend/apply-light-mode.js, a one-off codemod already applied.
    - CI: actions/checkout v5, setup-node v5, setup-python v6 (Node 20 actions
    are deprecated on GitHub runners).
2026-10-09 docs: add SECURITY.md and CHANGELOG.md
    - SECURITY.md: supported versions (4.3.0 must not be deployed), private
    reporting through GitHub's "Report a vulnerability", scope, and the known
    limitations already tracked (shared device password, open setup hotspot,
    no physical reset).
    - CHANGELOG.md: 5.0.0 entry covering everything since v4.3.0, grouped as
    Breaking / Security / Changed / Added / Fixed / Removed, with upgrade
    steps; 4.3.0 marked as superseded.
2026-10-09 docs: correct license summary and medical disclaimer
    - The GPLv3 summary claimed commercial users must open-source their
    "entire proprietary codebase". GPLv3 obligations apply when the work or
    a modified version is distributed, and cover that work. Reworded to say
    that, point to LICENSE as the authority, and note it is not legal advice.
    - The disclaimer referred to the US FDA. RespiroSync is built in Malaysia,
    where the Medical Device Authority regulates medical devices under Act
    737. State plainly that it is not a registered device and not clinically
    validated, and that cough detection is a loudness heuristic.
    - Link SECURITY.md and CHANGELOG.md; Laravel badge 11 -> 12.
2026-10-09 feat(firmware): drive a passive buzzer; compile firmware in CI
    The kit uses a passive buzzer, which only clicks on a steady HIGH. All
    buzzer output (local threshold alarm, cough chirp, cloud buzzer_on) now
    goes through setBuzzer(), which plays a 2.7 kHz tone() and idles LOW so no
    DC flows through a magnetic coil.
    CI compiles the ESP32 sketch on arduino-esp32 2.0.17 and the latest 3.x
    (the Arduino IDE default), using secrets.example.h, and both Pico sketches
    on arduino-pico.
    [esp32_firmware.ino]
2026-10-09 docs(hardware): rewrite the wiring guide for the actual kit
    - Parts list for the reference build.
    - Split power: MB-102 (9 V in, 5 V rail) feeds the MQ-135, Sharp sensor,
    LCD and level shifter; ESP32 and Pico run from USB; grounds shared;
    never tie the MB-102 5 V to a board's 5 V/VIN/VSYS. Why (linear regulator
    heat) and the multimeter rule for an LM2596 instead.
    - Sharp GP2Y1010AU0F, bare 6-wire: 150 ohm made from 220 || 470 ohm,
    220 uF on V-LED, divider on Vo.
    - Bare 4-pin DHT22 with 10k pull-up; LCD I2C through a BSS138 level shifter
    (the PCF8574T backpack pulls SDA/SCL to 5 V); passive buzzer through
    220 ohm; LEDs 220 ohm.
    - Pin summary and a bring-up order.
    - README, PROJECT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
2026-10-09 docs(hardware): DHT22 3-pin module wiring (built-in pull-up)
2026-10-09 docs(hardware): power the MB-102 before the ESP32 (LCD init)
2026-10-09 feat(firmware): log raw dust and MQ-135 readings to Serial
    A sensor output below ~0.59 V maps to PM2.5 0.0, so 0.0 alone cannot tell
    a wiring fault from a low clean-air baseline. Print the raw pin millivolts,
    the voltage at the sensor and the MQ-135 ADC value every 5 s.
2026-10-09 fix(frontend): show device offline after 30 s instead of 90 s
    The ESP32 publishes every 5 s; 90 s kept the last values on screen for a
    minute and a half after a device went offline.
2026-10-09 fix(firmware): self-calibrating dust baseline, averaged readings
    The fixed Nafis formula (170 * V - 100) assumes a clean-air output of about
    0.59 V. The test unit idles at 0.48-0.53 V, so it reported 0.0 in normal air
    and only registered heavy dust. Each GP2Y1010 has its own Voc (datasheet
    0-1.5 V).
    - Learn the clean-air baseline as the lowest averaged reading since boot;
    convert the rise with the datasheet typical sensitivity (0.5 V per
    0.1 mg/m3). Same firmware on every unit.
    - Average 25 LED pulses (0.25 s) per reading instead of one.
    - Serial log shows the learned baseline.
    - Wiring guide: colours are supplier-specific, identify pins by position;
    calibration and its limits (boot i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
    [esp32_firmware.ino]
2026-10-09 fix: honest dashboard wording, gas units and learning state
    - AI predict: an untrained model / no recent data (engine 400/404) returns
    200 {learning: true, model_stage: "Learning mode"} instead of an error;
    engine failures stay errors. Tests cover all three cases.
    - Gas: label the MQ-135 value "raw" (ADC 0-4095), not "ppm", here and in
    Smart Alerts; the air-quality card shows "Gas High" when gas exceeds its
    limit (the card used to ignore gas while the banner counted it).
    - Limit badges say "auto" (AI optimisation enabled) instead of "AI"; the
    limits are defaults until the model has enough data.
    - Banners: "Cough-like Sound Detected" (loudness detector, last 12 hours)
    instead of "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
2026-10-09 fix(frontend): "AI" limit badge follows the model state; drop dust note
    The AI engine is hybrid: Stage 1 (anomaly detection on the room's normal
    readings, no doses needed) or Stage 2 (Random Forest on logged episodes),
    and ai:optimize applies its limits every 5 minutes. So the limits are
    AI-set whenever a model exists, and not while the engine is learning.
    - LiveMonitor asks /api/ai/predict once a minute; the badge reads "AI"
    (hover: which stage) only when a model exists and AI optimisation is on,
    and is hidden while learning. Replaces the always-on "auto" badge.
    - Remove the dust-band footnote from the card (kept as hover text on the
    PM2.5 label).
2026-10-09 feat: estimated gas ppm, smoother live updates, stable online status
    Gas as estimated ppm
    - Firmware converts the MQ-135 reading to Rs/RL and applies the datasheet
    curve (ppm = a * (Rs/R0)^-2.769), calibrated against the cleanest air
    seen since boot taken as 420 ppm. RL cancels out, so the module's load
    resistor need not be known. Sends null when there is no signal.
    - Default gas limit 1000 ppm in firmware, backend, AI engine and
    dashboard; AI engine tiers 800/900, floor 700. Migration resets existing
    gas limits (raw-scale values are meaningless in ppm). Backend accepts
    0-10000. Dashboard and Smart Alerts show "ppm (est.)" with an
    explanation; slider 450-3000.
    Smooth, consiste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
    [esp32_firmware.ino]
2026-10-09 fix: AI engine DB connection, config re-sync on deploy, Stage 1 wording
    - ai_engine: build the MySQL URL with sqlalchemy URL.create instead of
    string formatting. A password containing '@' made the engine connect to
    host '<part of password>@db'; /predict hid it (it checks for a model
    file before touching the DB) and /train returned 500, so no model could
    ever be trained. CI now builds the URL with 'p@ss:w/rd#1'.
    - MQTT worker re-publishes every device's current limits (retained) on
    start, i.e. after every backend deploy. The ppm migration changed the
    gas limit in the database, but devices kept the old retained 300 and
    alarmed at ~430 ppm while the dashboard used 1000. Test inclu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
2026-10-09 fix(frontend): air-quality card labels and limit colour match the climate card
    Drop the visible "(est.)" from the PM2.5 and Gas labels (the hover text
    still explains both are estimates) and give the two limit lines the same
    dark-mode colour as the temperature and humidity limits.
2026-10-09 fix(ai): never suggest a limit inside the room's own normal range
    Stage 1 picked one of three fixed limit sets by anomaly level, ignoring
    the room's baseline. In a Kota Kinabalu room that is normally 69.6 %
    humidity and 30.4 C, the "unusual" set (humidity 65 %, temperature 32 C)
    and the "very unusual" set (60 %, 30 C) put limits inside the normal
    range, so ai:optimize made the device alarm continuously.
    - respect_room_normal(): a suggested limit is at least the learned mean +
    2 std of that reading, and clamped to a safety range (PM2.5 15-55,
    temperature 26-38, humidity 55-90, gas 700-3000). Applied at both
    stages; replaces the Stage 2 floors.
    - Training saves the room baseline at both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
2026-10-09 fix(ai): only rescue doses are episodes; controller dose is an input (C1)
    fetch_user_data read every inhaler log as an episode label, so a daily
    controller (preventive) dose made the hour before it look like an attack.
    - Inhaler logs are split by type: rescue doses (and 2+ coughs) label the
    next hour; controller doses feed a new input, controller_24h (dose in
    the 24 h up to the window), at training and prediction.
    - predict(): a saved model with the old feature count is ignored (Stage 1
    or Learning mode) until the next training run replaces it.
    - Response reports controller_dose_last_24h.
    - test_dataset.py builds 5 h of synthetic data with a controller dose at
    00:55 and a rescue dos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
2026-10-09 feat(ai): model sized to the data, recall/precision instead of accuracy (C2)
    - Below 12 episode windows (~2 episodes) the account stays on Stage 1;
    logistic regression (scaled, balanced) up to 19; Random Forest from 20
    (DESIGN_MULTI_PATIENT.md 5.3).
    - Time-ordered hold-out on the latest 25% reports recall, precision and
    the number of held-out episode windows; with fewer than 2, no score is
    claimed. Plain accuracy is gone (an always-"safe" model scored ~95%).
    - Model type and evaluation are saved with the model and returned by
    /predict; the AI panel shows them for Stage 2.
    - Threshold tightening uses feature_weights(): forest importances or
    |coefficients| of the standardised logis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
2026-10-09 fix(frontend): plain wording in the AI panel (flare-ups, not episodes)
    Parents saw "no episodes logged yet" without knowing what an episode is.
    Stage 1 now reads "Room compared with its usual readings" with a hint
    that personal risk prediction starts after about 2 recorded flare-ups
    (rescue inhaler dose or 2+ coughs in an hour); the redundant Low pill is
    hidden. Stage 2 says "flare-up" and shows an approximate flare-up count
    instead of episode windows.
2026-10-09 feat: user limit is a cap with an optional lock; bars against the limit (C3)
    Caps and locks (all four limits)
    - Migration adds <name>_cap and <name>_locked to hardware_configs;
    existing limits become caps. <name>_threshold stays the effective
    limit the device uses.
    - Saving Smart Alerts sets cap = effective = the user's value, plus locks
    (HardwareConfig::applyUserSettings).
    - ai:optimize applies min(cap, suggestion), or the cap when locked
    (HardwareConfig::limitsFromSuggestion), and publishes only when a limit
    changes.
    - AI engine returns room_normal_limits (mean + 2 std); the dashboard
    shows "AI" when the AI lowered a limit, "locked", and "!" when a limit
    sits inside the room'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
2026-10-09 feat(ai): limits move at most 10 % per day, only after 24 h of data (C4)
    Stage 1 flips between "Normal" and "Unusual" as readings fluctuate, so
    ai:optimize could swing a limit every 5 minutes.
    - AI engine: the room baseline records how many windows it covers;
    /predict returns training_windows and ready_to_adjust (>= 144 windows,
    24 h). ai:optimize skips accounts that are not ready.
    - Each limit may move at most 10 % from its value at the start of the
    current 24-hour window (<name>_day_start, ai_day_started_at; new
    migration). The cap still wins at once; a user change in Smart Alerts
    resets that limit's reference.
    - Tests: 10 % on day one, no further move the same day, another 10 %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
2026-10-09 feat(ai): log every alert limit change; limits return to the user's values while the AI is not ready (C5)
    - limit_changes table: limit, old -> new, ai/user, reason, time
    - ai:optimize logs its changes with a plain reason (Stage 1 room level or Stage 2 risk)
    - Smart Alerts saves are logged as user changes
    - while the AI is learning or has < 24 h of readings, every limit is the user's cap
    (undoes limits lowered before C4 or before an AI reset); engine errors change nothing
    - Activity Log shows the week's changes (/api/report limit_changes)
2026-10-09 fix(ai): at most one AI change per limit per day; Activity Log shows one line per update
    - a limit the AI already moved in the current 24 h window is held until the next one,
    so a Stage 1 room flipping normal/unusual no longer swings limits (and the log) all day
    - a Smart Alerts change, or a restore while the AI is not ready, starts a fresh day for that limit
    - rows of one update share a timestamp; the report groups them into one line (short printed PDF)
2026-10-09 feat(dashboard): one rule for bar colours and card headlines
    - lib/readingStatus.ts: green below the limit, amber near it (dust/gas 20 %, temperature 2 C,
    humidity 5 %), red above it; used by the bars, both card headlines and standby mode
    - air quality reads like room climate: Clean Air / Fair Air / Dusty, Slightly Dusty / Slightly
    Stuffy, Action Needed
    - bars start at a no-worry floor (gas 400 ppm, 20 C, 40 %) and are full at the limit
    - standby mode defaults to the 75 % humidity limit
2026-10-09 feat(ai): limits learned from the room (C6)
    - a normal room's suggestion is mean + 3 std of its usual readings (within the safety range)
    instead of the fixed defaults; unusual / very unusual tighten to mean + 2.5 / 2 std instead
    of fixed limit sets; Stage 2 tightens from the learned limits
    - gas keeps 1000 ppm (the MQ-135 estimate drifts too much to learn)
    - stage1() and room_limits() are pure functions, checked in CI with the reference room's baseline
    - log reason for a normal room: "Learned from your room's usual readings (Stage 1)"
2026-10-09 feat(patients): patients, per-device limits, last seen (multi-patient phase 2, backend)
    - patients + patient_user (roles owner/caregiver/viewer; phase 2 creates owners)
    - devices.patient_id (NULL = shared room), devices.last_seen_at -> online/offline (20 s)
    - hardware_configs one row per device; a child's new room starts from that child's limits
    - inhaler_logs.patient_id, limit_changes.device_id
    - central access: PatientPolicy, DevicePolicy, Controller::device()/patient(); strangers get 404
    - device_id on telemetry/cough-events/config, patient_id on doses/report; defaults keep the
    current dashboard working
    - /api/patients CRUD, PATCH /api/devices/{id}
    - ai:optimize per device (one AI call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
2026-10-09 feat(dashboard): room picker, Children & rooms, per-child report (multi-patient phase 2)
    - lib/rooms.tsx: devices + patients of the account and the room on screen (remembered per
    browser); live values, Sleep Mode, cough history and Smart Alerts follow it
    - header room picker with child and online/offline dot
    - medication panel logs doses for the room's child
    - Account Settings > Children (add, rename, delete) and Rooms (rename, move to a child or
    shared room, last seen, remove, pair for a chosen child)
    - Activity Log per child with a picker (hidden in print); room shown on limit changes
2026-10-09 feat(sharing): invite, roles, removal, alert fan-out, audit log (multi-patient phase 3, backend)
    - patient_invites: emailed one-time token (hash stored), 7 days, needs the invited email
    - members API: list, change role, remove, leave; a child always keeps an owner
    - patient_user.alerts: cough alerts to every member with alerts on (viewers opt in)
    - 403 for members without the right, 404 for strangers
    - account deletion: shared child needs confirmation; a co-owner keeps child, rooms, limits
    - audit_logs for sharing, children, rooms, settings, doses and cough marks
2026-10-10 feat(dashboard): sharing UI, invitation page, role-aware dashboard (multi-patient phase 3)
    - SharePanel per child: members and roles, pending invites, invite form, own alerts switch,
    leave, history (audit log)
    - Children & rooms: Share per child, 'Shared with you' section, pairing only for own children
    - /invite page: sign in or register with the invited email, come back, accept
    - login/register return to an opened invite link (invite paths only, no open redirect)
    - viewers: no Log Dose, no cough review, read-only Smart Alerts with a note
    - account deletion asks again for shared children
2026-10-10 fix(dashboard): header layout on phones
    - room picker on its own full-width row; Sleep, Activity Log, theme and logout share one row
    below it, equal width and height (one line next to the title from sm up)
    - theme and logout buttons take sizing from the header; logout lost its stray left margin
    - dropdown arrow on the room picker when there is more than one room
2026-10-10 feat(ai): room model per device, risk model per child (multi-patient phase 4)
    - engine: /train/room?device_id (room baseline), /train/risk?patient_id (risk model from the
    child's own rooms in time order, shared rooms excluded), /predict?device_id
    - models device_<id>_* and patient_<id>_*; old user_<id>_* files are not read
    - backend: AiEngine client; ai:optimize predicts per room; ai:train command (every 4 h) trains
    every room then every child; /api/ai/predict and /api/ai/train per room with access checks
    - dashboard: AI panel, AI badges and training triggers follow the room picker
    - tests: room/risk training incl. a two-room child, per-room calls, stranger 404, ai:train
2026-10-10 feat(telemetry): nightly retention: 7 days raw, 10-minute averages for a year
    - telemetry:prune (daily 03:30): readings older than 7 days become one average per device per
    10 minutes (samples = readings replaced), all readings older than a year are deleted
    - averages skip failed sensor values instead of counting them as 0; safe to run again
    - telemetry_logs.samples and a (device_id, recorded_at) index (also speeds up the dashboard poll)
    - only sensor readings; coughs, doses, limit changes and the audit log are never touched
    - agreed with the project owner on 2026-10-10
2026-10-10 feat(push): switch on push notifications in the dashboard
    - Account Settings > Notifications on this device: permission, subscribe, register (lib/push.ts)
    - explains blocked / unsupported / iPhone needs Add to Home Screen
    - alert push names the room and child, one per room (tag), tap opens that room (/?device=)
    - service worker handles notification taps
    - DELETE /api/push-subscribe; both sign-outs unsubscribe the browser on the server
    - checks use getRegistration() so sign-out never hangs without a service worker
2026-10-10 feat(privacy): data export per child, AI models deleted with their room/child/account
    - GET /api/patients/{id}/export/{readings|coughs|doses|limits}: streamed CSV of that child's
    data (view right), formula-safe cells, BOM for Excel, audit log entry
    - Activity Log: Download <child>'s data (four files), hidden in print
    - engine DELETE /models; the backend calls it when a room, child or account is deleted
    - privacy page states where to download and how long readings are kept
    - tests never reach a real AI engine (default fake for /models)
2026-10-10 feat(ai): rising-fast and night inputs, gas limit learned per room
    - risk model inputs: + pm25_change, humidity_change (since the previous window), night (22-06)
    - /predict computes the same from this and the previous 10 minutes and the clock
    - room baseline learns gas (mean + 3 std, floor 700, MIN_STD 50) after 6 h of gas readings;
    gas counts for Stage 1 'unusual'; baselines without gas keep the default
    - telemetry columns forced numeric (an all-NULL gas column no longer breaks resampling)
    - old 5-input risk models are skipped until retrained (existing fallback)
2026-10-10 fix(firmware): built-in humidity limit 75 %, same as the server default
    Only used until the retained config arrives (boot without internet), where 60 % alarmed
    all the time in 65-70 % indoor air. Takes effect at the next flash.
    [esp32_firmware.ino]
2026-10-10 fix(dashboard): themed room picker list instead of the native dropdown
    - grouped by child, status dot and Online / Offline / Waiting for setup, tick on the current room
    - keyboard (arrows, Enter, Escape), closes on an outside tap, phone width
    - header above the cards so the list is not covered
2026-10-10 fix(wording): do not present RespiroSync as a medical product
    - register: no 'medical network'; consent says sensor and health data
    - emails: footer 'RespiroSync', no 'Medical Dashboard'; cough email names the room and child
    - medication notice: a fact plus 'talk to your doctor', no clinical interpretation
    - privacy and account deletion: 'health data' (PDPA's term) instead of 'medical data'
2026-10-10 feat(alerts): email and push when a reading stays over its limit for 5 minutes
    - DeviceMessageHandler::checkLimits on every reading: all readings in the last 5 minutes over
    the room's limit (dip or failed sensor restarts), window covered from its start
    - limit_alerts table: one per room and reading per hour while it stays high
    - LimitAlertNotification: email (limit_alert template) + push naming reading, room, value, limit
    - same recipients as cough alerts; the per-child switch and push text say 'alerts'
2026-10-10 fix(dashboard): themed dropdowns everywhere; icons on all report cards
    - ThemedSelect: one dropdown in the dashboard's style, rendered into <body> so it is not cut
    off or misplaced in the blurred, scrolling Account Settings window
    - used for the report's child picker, a room's child, the pairing child, member and invite roles
    - report summary cards: sound waves, ringing bell, inhaler, visible on screen and in print
2026-10-10 feat: account photo, child badges, Share PDF in the iPhone app
    - Account photo (users.avatar): cropped and resized to 256 px in the browser,
    checked server-side (real JPEG/PNG/WebP, max 512 px, no SVG); shown in
    Account Settings and the Share member list.
    - Child badge (patients.color / emoji) from fixed lists, owners only; shown in
    Children & rooms, the room picker and the Activity Log.
    - Activity Log: in the iOS Home Screen app, where window.print() does nothing,
    a PDF is drawn on canvas (same layout as the printout) and shared via the
    share sheet; CSV downloads use the share sheet there too. Report numbers and
    texts moved to lib/report.ts so the page and the PDF match.
2026-10-10 feat(lcd): icons, rotating pages, alert and cough screens, night mode, dose reminder
    - Firmware: custom icons, pages every 4 s (air, PM2.5 bar, gas + plain-words
    air line, clock), full alert screen with 3 backlight blinks, cough animation,
    boot animation, night mode 21:00-07:00 (BOOT button wakes / next page),
    flicker-free updates (only changed characters), NTP clock (UTC+8).
    - Backend: dose_due in the device config (daily inhaler used, none for 26 h);
    devices:dose-reminders every 5 minutes sends only changes; logging a daily
    dose clears it at once.
2026-10-10 feat(lcd): centred layout, titled pages, start-up steps, gas warm-up, clock fallback
    - Every line centred. Pages every 5 s with the title on top and values side
    by side below: Air quality (PM2.5 + gas), Room climate (temp + humidity),
    clock with the connection icon, Daily dose? while due. Bar page, status
    line and OK/HI! removed.
    - Start-up: boot animation, Connecting WiFi / setup hotspot, WiFi connected
    (network name), Setting clock, Connecting cloud, Ready.
    - Alerts: several readings over their limits take turns; Offline note when
    the connection drops; Check sensor when the DHT22 fails.
    - MQ-135 not read for its first 3 minutes (countdown on the LCD, gas sent as
    null), so a col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
    [esp32_firmware.ino]
2026-10-10 fix(esp32): ask the server for the time over MQTT instead of HTTPS
    The esp_http_client fallback added ~35 KB and pushed the sketch over the
    default app partition on core 3.x (101 %). The device now publishes a
    time_request event until its clock is set; the MQTT worker answers with a
    set_time command (Unix seconds). No extra library, works wherever MQTT does.
    [esp32_firmware.ino]
2026-10-10 fix(dashboard): align the child badge in the room picker; truncate long names
    Room, badge and child name are flex items on one line, so the badge is
    centred with the text; each name truncates with an ellipsis instead of
    overflowing the button. Group headings and room subtitles truncate too.
2026-10-10 feat(pico): test mode with a GP2 button or serial commands; wiring layout
    A short press sends a weak test cough, a long press a strong one ('c' / 's'
    in the Serial Monitor too), so the Pico -> ESP32 -> server -> alert path can be
    tested before the INMP441 arrives. Without a working I2S microphone the
    firmware now stays in test mode instead of halting. Wiring guide: test button,
    a Pico-only layout, pin summary (GP2, ESP32 BOOT), bring-up step 5.
    [pico_cough_ai.ino]
2026-10-10 feat(alerts): email and push when a device is offline for 30 minutes
    devices:offline-alerts (every 5 minutes) alerts a room's alert recipients
    once per outage (devices.offline_alerted_at); the next message from the
    device clears it and sends a 'back online' push that replaces the offline
    one on the phone. Devices that never connected are ignored.
2026-10-10 feat(esp32): firmware updates over Wi-Fi (ArduinoOTA)
    Network port respirosync-<token>, password OTA_PASSWORD from secrets.h
    (updates over Wi-Fi are off without it), progress on the LCD. Needs the
    'Minimal SPIFFS (1.9MB APP with OTA)' partition scheme; CI compiles with it.
2026-10-10 docs: demo script, diagrams, scheduled tasks; package version 6.1.0
    - docs/DEMO.md: a 12-minute demo with NAS commands to trigger the offline
    alert and the dose reminder on the spot, and the clean-up afterwards.
    - docs/DIAGRAMS.md: Mermaid diagrams (architecture, limit alert, cough,
    AI, device life cycle, sharing, LCD screens).
    - OPERATIONS: scheduled tasks and testing alerts; PROJECT_EXPLANATION: LCD
    and the other alerts; README links.
    - frontend/package.json and its lock: version 6.1.0 (was 5.0.0).
2026-10-10 docs(wiring): power the Pico from the ESP32's 5V pin (VSYS)
2026-10-10 fix(pico): no false bursts from a floating microphone line
    Pull the I2S data pin down (floating without a microphone, and per the
    INMP441 datasheet), ignore the first 3 s after power-on, and require a burst
    to last 2 consecutive 16 ms blocks. A test without a microphone reported a
    weak 'cough' at power-on.
    [pico_cough_ai.ino]
2026-10-10 chore(pico): remove the test mode (button and serial commands)
    The firmware is the plain microphone detector again, so fitting the INMP441
    needs no code change. Kept: the noise fix (pull-down, start-up settle, 32 ms
    minimum burst) and the LED blink per detection. Docs: test button removed;
    the wiring guide has a pin layout with the microphone and ESP32 links; the
    demo uses real coughs/claps.
    [pico_cough_ai.ino]
2026-10-10 feat(ota): cloud firmware updates for the ESP32; remove ArduinoOTA
    - firmware:publish checks an exported .ino.bin (ESP image magic, fits the
    1.9 MB OTA slot, appended SHA-256), reads the version from the file's
    'RespiroSync-firmware:x.y.z' marker and stores it in storage/app/firmware.
    - Owners see a dot on Account Settings and 'Update to x.y.z' per room. The
    server sends an MQTT 'ota' command with a one-time signed link (10 min,
    that device only, relative signature through the /api proxy) and the image
    digest.
    - ESP32: esp_https_ota with the certificate bundle, LCD progress, SHA-256
    check after writing (keeps the old slot on a mismatch), refuses during an
    alarm. Rollback: verif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
2026-10-10 test(ota): reset the stored device, not a stale copy
2026-10-10 feat(ota): GitHub Actions builds and publishes each new ESP32 firmware
    - POST /api/firmware/upload (raw .bin, Bearer FIRMWARE_UPLOAD_TOKEN, off
    without it; repeats of a published version are a harmless 200).
    - FirmwarePublisher shared by the upload and firmware:publish.
    - CI job 'Publish ESP32 firmware to the server': on pushes to main that
    change hardware/esp32_firmware, builds with secrets.h written from GitHub
    secrets and uploads it; never stores the .bin (it contains the device
    password). Skips with a notice until the secrets are set.
2026-10-10 feat(firmware): real-device versions (3.1.0 Build 261011) and friendly update screens
    - Firmware 3.1.0; CI writes build_info.h with the build stamp (YYMMDD, .N
    for the Nth firmware build that day); the device reports it, the LCD shows
    FW / Build at start-up and 'Updating 45%' / 'Don't unplug' while updating.
    - Server: releases and devices store the build; newer = version, then build;
    the first cloud builds' '6.2.0' / '6.2.1' labels map to 3.0.0 / 3.0.1
    (migration + hello). /api/devices adds firmware_label, update_available,
    latest_firmware.label and the product (RS-100 rev A).
    - Owners: dashboard banner, short statuses in Rooms, an 'Update available'
    dialog with What's new (from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
    [esp32_firmware.ino]
2026-10-10 feat: night mode switch per room (firmware 3.2.0)
    hardware_configs.night_mode (default on) in Smart Alerts and in the device
    config; the firmware keeps the LCD lit at night when it is off.
2026-10-10 feat: Edge AI (Pico) updates from the dashboard; ESP32 firmware 3.3.0
    - Pico (Edge AI 2.0.0): own version and build, HELLO / VER? on the UART
    link (now 115200), receives updates in numbered CRC-16 frames into its FS
    area (arduino-pico Updater) and installs them on restart; keeps answering
    without a microphone.
    - ESP32 3.3.0: learns the Edge AI version, reports it in hello, and for an
    "ota" command with target "pico" downloads the build, checks its SHA-256
    while sending it on, and only then lets the Pico install it.
    - Server: firmware_releases.target (esp32 | pico, version unique per
    target), devices.edge_ai_* and ota_target; updates for either part;
    /api/devices adds edge_ai_la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
2026-10-10 feat(edge-ai): 2.0.1 repeats its version to the ESP32 every 10 minutes
    First Edge AI build to install from the cloud (through the ESP32). Also
    records the published builds (3.3.0 Build 261010.9, Edge AI 2.0.0 Build
    261010.4) in FIRMWARE_HISTORY.md.
2026-10-10 fix(dashboard): AI card content at the top, with a line on what Stage 2 needs
    The card is stretched to its neighbours' height and its content sat at the
    bottom, leaving a gap above "Normal". Content now starts at the top, the
    cough count stays at the bottom, and Learning / Stage 1 explain in one line
    what comes next.
2026-10-10 fix(dashboard): remove the Stage 1 / Learning hint from the AI card
2026-10-10 docs(wiring): DC adapter + USB power layout, Pico powered from the ESP32, Edge AI settings
    Power section shows the reference build: a 9 V DC adapter on the MB-102 for
    the sensors and LCD, USB for the ESP32, and the ESP32's 5V feeding the Pico's
    VSYS. Adds the Pico Flash Size and ESP32 partition scheme, the 115200 link
    and its version requirement, the Pico power pins in the summary, and
    updated bring-up steps. Sentences no longer use semicolons.
2026-10-10 docs(readme): describe the finished system
    Room Monitor (RS-100) with the ESP32 main unit and the Edge AI module
    (Pico + INMP441), the LCD and night mode, all alerts (coughs, limits for
    5 minutes, device offline), cough review, medication and dose reminder,
    over-the-air updates for both chips with automatic publishing, the PDF
    Activity Log, profile photos and child badges, current MQTT topics,
    firmware versions, setup with the partition scheme and Flash Size, and an
    Edge Impulse roadmap.
2026-10-11 feat(edge-ai): Edge Impulse cough model (Edge AI 3.0.0)
    The Pico now runs a neural network trained in Edge Impulse (Audio MFE + 1D CNN,
    int8) that tells a cough apart from talking, TV, laughing, throat clearing and
    traffic, instead of reacting to any loud sound. 93 % on validation, 86 % on
    unseen test sounds; 258 ms per window on the RP2040.
    - Core 1 records the INMP441 without a break into a 1 s ring buffer; core 0
    classifies the last second every 0.5 s. A cough counts when the cough score,
    averaged over two windows in a row, reaches 0.6.
    - COUGH:<level>,<score>: level is the loudness, score the model's confidence.
    Dashboard, email and report wording follow; the alert rule is unchang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
2026-10-11 fix(dashboard): say why an update didn't finish
    The device reports the reason (an active alarm, no answer from the Edge AI
    module, an interrupted download...), but Rooms only said "Update didn't
    finish". Show it above "Your device is still working normally."
2026-10-11 docs(wiring): final parts list, resistor and capacitor plan, breadboard layout
    - Resistors from the kit (no 220 ohm): 240 ohm for the LEDs and buzzer,
    240 || 470 ohm (159 ohm) for the Sharp LED, 10k/20k dividers as before.
    - Four capacitors: 1000 uF on the MB-102 5 V rail, 220 uF 16 V on Sharp
    pin 1, 220 uF on the ESP32 3V3 (Wi-Fi peaks) and on the Pico VSYS (quiet
    microphone supply).
    - Two joined boards: 5 V side with the Pico on board A, 3.3 V side on
    board B, ESP32 across the join, MB-102 output 2 off.
    - Power budget, WROOM vs WROVER note, placement rules.
2026-10-13 fix(esp32): fallback DNS and lookup retries before update downloads (3.3.1)
    An Edge AI update failed with getaddrinfo() 202: the router missed one DNS
    answer for the download host while MQTT, already connected, kept working.
    - 1.1.1.1 as the fallback DNS server (the router's DNS stays first).
    - Before any update download, look the server up, up to 3 tries.
    - If it still fails: "Server not found" with a clear reason in the
    dashboard, instead of "The download did not start".
2026-10-13 feat(esp32): find the LCD at 0x27 or 0x3F by itself
    PCF8574T backpacks answer at 0x27, PCF8574AT ones at 0x3F; with the wrong
    address the backlight is on but no text ever appears. Probe both at start-up
    and print which one answered (or what to check when neither does).
2026-10-13 fix(esp32): ask 1.1.1.1 first, the router second (3.3.2)
    3.3.1's fallback DNS did not help: the router answers some lookups with an
    error (getaddrinfo 202) rather than staying silent, and lwIP only moves on to
    the next server after a timeout. Now 1.1.1.1 is the main server, the router
    the backup and 8.8.8.8 the fallback; a network that blocks 1.1.1.1 still works
    through the timeout. Re-applied after every MQTT disconnect, since a DHCP
    renewal puts the router back first.
    Tested on the device over USB: MQTT connected on the first try (it took 2-4
    tries before).
2026-10-13 feat(edge-ai): print cough score and mic level on USB (3.0.1)
    Whenever a PC has the Pico's USB serial port open, print every window's cough
    score, the two-window score and the loudest 16 ms RMS. A level near 0 all the
    time means no signal from the microphone. Replaces the compile-time
    DEBUG_SCORES switch, so checking a microphone needs no reflash.
2026-10-13 feat(edge-ai): hum filter, gain 4x, record over USB (3.0.2)
    Tested on the device with the INMP441 (scores and levels over USB):
    - The signal carried 50 Hz mains hum (harmonics to ~800 Hz) about 10x
    stronger than everything above 1 kHz. A 200 Hz Butterworth high-pass on
    core 1 replaces the DC blocker.
    - At 8x gain a cough reached ~10,000 (loudest 16 ms) and scored 0.00; at 1x
    it sank to the noise floor; at 4x coughs land near the training level and
    score up to 0.6. MIC_SHIFT 13 -> 14.
    - USB command "rec <seconds>" streams raw audio exactly as the model hears
    it. hardware/tools/record_audio.ps1 saves it as WAV, cut_clips.ps1 cuts
    1-second cough/noise clips for Edge Impulse. Replace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
2026-10-13 fix(tools): cut_clips writes to the folder PowerShell means
    .NET file calls resolve relative paths from the process directory, not the
    PowerShell location, so a relative -OutDir failed. Resolve it first.
2026-10-13 feat(tools): cut_clips -Gain for quieter copies of each clip
    Quieter copies (e.g. -Gain 0.5,0.7) stand in for coughs farther from the
    microphone and give the device's own recordings more weight next to the
    public training data. Values are clamped to 16 bits.
2026-10-13 feat: cough sensitivity learns from the reviews; model retrained on the device mic
    The device sends no audio, so cough reviews cannot retrain the model. They now
    move each room's cough threshold instead (a documented rule):
    - hardware_configs.cough_threshold (0.6, between 0.40 and 0.85), sent to the
    device; ESP32 3.4.0 passes it to the Edge AI module as THR:<score>.
    - Possible coughs: Edge AI 3.1.0 reports MAYBE:<level>,<score> up to 0.15 under
    the threshold when the window holds a clear burst (loudest 16 ms >= 4x its
    median), at most one per 20 s. Stored with cough_events.is_possible; they
    never alert and count nowhere (report, alert rule, banner, AI engine) until
    confirmed. Show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
2026-10-13 feat: robustness pack (firmware 3.5.0, Edge AI 3.2.0)
    From the code review of both firmwares:
    ESP32 3.5.0
    - Coughs and possible coughs are held (40, with their time) while the cloud is
    unreachable and sent on reconnect with "ts"; the server keeps the device's
    time for events that waited > 1 min and does not alert on ones > 5 min old.
    - Local alarms: 3 readings over the limit to start, 3 under the limit minus a
    margin to stop. BOOT held 2 s silences the buzzer for 10 min.
    - Only dust, gas and app alerts block an update.
    - Last limits kept in flash (Preferences) and used after a restart offline.
    - Loop watchdog (5 s; off during updates); publishes are queued for the MQTT
    task (esp_mqt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
2026-10-24 fix(standby): offline and cough rules from the dashboard; service worker skips other sites
    StandBy showed the newest reading however old it was, so with the device
    off it kept its last values and "Monitoring Active". It now uses the
    dashboard's offline rule (no reading for 20 s by the server's clock) and
    its cough rule (newest unreviewed cough, 2 hours), both moved to
    lib/deviceStatus.ts. The service worker no longer intercepts requests to
    other sites, so a blocked Cloudflare analytics beacon is no longer an
    uncaught error.
