anake-an/asthma-monitoring-system/(notices)

Notices in the files:
README.md:
License: GPLv3
